Ledust-creat/mspm0-ball-balancing-car/chaiss/README.md

# MSPM0G3507 车载钢球平衡控制系统

完整项目介绍、功能、接线、构建步骤和已知问题见[仓库首页 README](../README.md)。

本目录为 MCU 固件工程；Keil 构建入口为 `keil/main.uvprojx`，芯片配置源文件为 `main.syscfg`。
