Ledust-creat/mspm0-ball-balancing-car/chaiss/app/app_chassis_control.h

#ifndef APP_CHASSIS_CONTROL_H_
#define APP_CHASSIS_CONTROL_H_

#include <stdbool.h>
#include <stdint.h>

#ifdef __cplusplus
extern "C" {
#endif

/*
*********************************************************************************************************
*   宏定义
*********************************************************************************************************
*/
#define APP_CHASSIS_CONTROL_MODE_LINE_FOLLOW    (0U)      /* 循迹外环 */
#define APP_CHASSIS_CONTROL_MODE_GYRO_YAW       (1U)      /* 陀螺仪yaw外环 */
#define APP_CHASSIS_CONTROL_MODE_SPEED_TEST     (2U)      /* 纯速度环测试 */

#ifndef APP_CHASSIS_CONTROL_MODE
#define APP_CHASSIS_CONTROL_MODE                APP_CHASSIS_CONTROL_MODE_LINE_FOLLOW
#endif

/*
*********************************************************************************************************
*   类型定义
*********************************************************************************************************
*/
typedef struct
{
    float base_speed_cm_s;                  /* 普通模式基础速度 */
    float target_base_speed_cm_s;           /* 移动控球斜坡目标速度 */
    float planned_base_speed_cm_s;          /* 斜坡规划后的基础速度 */
    float planned_accel_cm_s2;              /* 最近一次规划加速度 */
    float mobile_accel_step_cm_s;           /* 每20ms加速步长 */
    float mobile_decel_step_cm_s;           /* 每20ms减速步长 */
    float steering_correction_cm_s;         /* 当前转向修正速度 */
    uint8_t control_mode;                   /* 当前外环模式 */
    bool is_running;                        /* 底盘运行状态 */
    bool ball_priority_mode;                /* 移动控球速度规划使能 */
    bool soft_stopped;                      /* 斜坡停车完成标志 */
} APP_ChassisControlState_t;

/*
*********************************************************************************************************
*   函数声明
*********************************************************************************************************
*/
void APP_ChassisControl_Init(void);
void APP_ChassisControl_Task(void);
void APP_ChassisControl_Start(void);
void APP_ChassisControl_Stop(void);
void APP_ChassisControl_SetBaseSpeedCmps(float base_speed_cm_s);
void APP_ChassisControl_SetTargetBaseSpeed(float speed_cm_s);
void APP_ChassisControl_SetBallPriorityMode(bool enable);
void APP_ChassisControl_SetMobileRampStep(float accel_step_cm_s,
                                          float decel_step_cm_s);
void APP_ChassisControl_RequestSoftStop(void);
bool APP_ChassisControl_IsSoftStopped(void);
float APP_ChassisControl_GetPlannedAccelCmps2(void);
void APP_ChassisControl_GetState(APP_ChassisControlState_t *state);

#ifdef __cplusplus
}
#endif

#endif /* APP_CHASSIS_CONTROL_H_ */
