Ledust-creat/mspm0-ball-balancing-car/chaiss/ti_msp_dl_config.c

/*
 * Copyright (c) 2023, Texas Instruments Incorporated
 * All rights reserved.
 *
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
 * *  Redistributions of source code must retain the above copyright
 *    notice, this list of conditions and the following disclaimer.
 *
 * *  Redistributions in binary form must reproduce the above copyright
 *    notice, this list of conditions and the following disclaimer in the
 *    documentation and/or other materials provided with the distribution.
 *
 * *  Neither the name of Texas Instruments Incorporated nor the names of
 *    its contributors may be used to endorse or promote products derived
 *    from this software without specific prior written permission.
 *
 * THIS SOFTWARE IS PROVIDED BY THE COPYRIGHT HOLDERS AND CONTRIBUTORS "AS IS"
 * AND ANY EXPRESS OR IMPLIED WARRANTIES, INCLUDING, BUT NOT LIMITED TO,
 * THE IMPLIED WARRANTIES OF MERCHANTABILITY AND FITNESS FOR A PARTICULAR
 * PURPOSE ARE DISCLAIMED. IN NO EVENT SHALL THE COPYRIGHT OWNER OR
 * CONTRIBUTORS BE LIABLE FOR ANY DIRECT, INDIRECT, INCIDENTAL, SPECIAL,
 * EXEMPLARY, OR CONSEQUENTIAL DAMAGES (INCLUDING, BUT NOT LIMITED TO,
 * PROCUREMENT OF SUBSTITUTE GOODS OR SERVICES; LOSS OF USE, DATA, OR PROFITS;
 * OR BUSINESS INTERRUPTION) HOWEVER CAUSED AND ON ANY THEORY OF LIABILITY,
 * WHETHER IN CONTRACT, STRICT LIABILITY, OR TORT (INCLUDING NEGLIGENCE OR
 * OTHERWISE) ARISING IN ANY WAY OUT OF THE USE OF THIS SOFTWARE,
 * EVEN IF ADVISED OF THE POSSIBILITY OF SUCH DAMAGE.
 */

/*
 *  ============ ti_msp_dl_config.c =============
 *  Configured MSPM0 DriverLib module definitions
 *
 *  DO NOT EDIT - This file is generated for the MSPM0G350X
 *  by the SysConfig tool.
 */

#include "ti_msp_dl_config.h"

DL_TimerA_backupConfig gChassis_Motor_PWMBackup;
DL_SPI_backupConfig gSPI_ICM20602Backup;

/*
 *  ======== SYSCFG_DL_init ========
 *  Perform any initialization needed before using any board APIs
 */
SYSCONFIG_WEAK void SYSCFG_DL_init(void)
{
    SYSCFG_DL_initPower();
    SYSCFG_DL_GPIO_init();
    /* Module-Specific Initializations*/
    SYSCFG_DL_SYSCTL_init();
    SYSCFG_DL_Chassis_Motor_PWM_init();
    SYSCFG_DL_TIMER_Chassis_Motor_Encoder_Read_init();
    SYSCFG_DL_I2C_0_init();
    SYSCFG_DL_UART_BLUETOOTH_init();
    SYSCFG_DL_UART_HTS25L_init();
    SYSCFG_DL_SPI_ICM20602_init();
    /* Ensure backup structures have no valid state */
	gChassis_Motor_PWMBackup.backupRdy 	= false;


	gSPI_ICM20602Backup.backupRdy 	= false;

}
/*
 * User should take care to save and restore register configuration in application.
 * See Retention Configuration section for more details.
 */
SYSCONFIG_WEAK bool SYSCFG_DL_saveConfiguration(void)
{
    bool retStatus = true;

	retStatus &= DL_TimerA_saveConfiguration(Chassis_Motor_PWM_INST, &gChassis_Motor_PWMBackup);
	retStatus &= DL_SPI_saveConfiguration(SPI_ICM20602_INST, &gSPI_ICM20602Backup);

    return retStatus;
}


SYSCONFIG_WEAK bool SYSCFG_DL_restoreConfiguration(void)
{
    bool retStatus = true;

	retStatus &= DL_TimerA_restoreConfiguration(Chassis_Motor_PWM_INST, &gChassis_Motor_PWMBackup, false);
	retStatus &= DL_SPI_restoreConfiguration(SPI_ICM20602_INST, &gSPI_ICM20602Backup);

    return retStatus;
}

SYSCONFIG_WEAK void SYSCFG_DL_initPower(void)
{
    DL_GPIO_reset(GPIOA);
    DL_GPIO_reset(GPIOB);
    DL_TimerA_reset(Chassis_Motor_PWM_INST);
    DL_TimerG_reset(TIMER_Chassis_Motor_Encoder_Read_INST);
    DL_I2C_reset(I2C_0_INST);
    DL_UART_Main_reset(UART_BLUETOOTH_INST);
    DL_UART_Main_reset(UART_HTS25L_INST);
    DL_SPI_reset(SPI_ICM20602_INST);

    DL_GPIO_enablePower(GPIOA);
    DL_GPIO_enablePower(GPIOB);
    DL_TimerA_enablePower(Chassis_Motor_PWM_INST);
    DL_TimerG_enablePower(TIMER_Chassis_Motor_Encoder_Read_INST);
    DL_I2C_enablePower(I2C_0_INST);
    DL_UART_Main_enablePower(UART_BLUETOOTH_INST);
    DL_UART_Main_enablePower(UART_HTS25L_INST);
    DL_SPI_enablePower(SPI_ICM20602_INST);
    delay_cycles(POWER_STARTUP_DELAY);
}

SYSCONFIG_WEAK void SYSCFG_DL_GPIO_init(void)
{

    DL_GPIO_initPeripheralAnalogFunction(GPIO_HFXIN_IOMUX);
    DL_GPIO_initPeripheralAnalogFunction(GPIO_HFXOUT_IOMUX);

    DL_GPIO_initPeripheralOutputFunction(GPIO_Chassis_Motor_PWM_C0_IOMUX,GPIO_Chassis_Motor_PWM_C0_IOMUX_FUNC);
    DL_GPIO_enableOutput(GPIO_Chassis_Motor_PWM_C0_PORT, GPIO_Chassis_Motor_PWM_C0_PIN);
    DL_GPIO_initPeripheralOutputFunction(GPIO_Chassis_Motor_PWM_C1_IOMUX,GPIO_Chassis_Motor_PWM_C1_IOMUX_FUNC);
    DL_GPIO_enableOutput(GPIO_Chassis_Motor_PWM_C1_PORT, GPIO_Chassis_Motor_PWM_C1_PIN);

    DL_GPIO_initPeripheralInputFunctionFeatures(GPIO_I2C_0_IOMUX_SDA,
        GPIO_I2C_0_IOMUX_SDA_FUNC, DL_GPIO_INVERSION_DISABLE,
        DL_GPIO_RESISTOR_NONE, DL_GPIO_HYSTERESIS_DISABLE,
        DL_GPIO_WAKEUP_DISABLE);
    DL_GPIO_initPeripheralInputFunctionFeatures(GPIO_I2C_0_IOMUX_SCL,
        GPIO_I2C_0_IOMUX_SCL_FUNC, DL_GPIO_INVERSION_DISABLE,
        DL_GPIO_RESISTOR_NONE, DL_GPIO_HYSTERESIS_DISABLE,
        DL_GPIO_WAKEUP_DISABLE);
    DL_GPIO_enableHiZ(GPIO_I2C_0_IOMUX_SDA);
    DL_GPIO_enableHiZ(GPIO_I2C_0_IOMUX_SCL);

    DL_GPIO_initPeripheralOutputFunction(
        GPIO_UART_BLUETOOTH_IOMUX_TX, GPIO_UART_BLUETOOTH_IOMUX_TX_FUNC);
    DL_GPIO_initPeripheralInputFunction(
        GPIO_UART_BLUETOOTH_IOMUX_RX, GPIO_UART_BLUETOOTH_IOMUX_RX_FUNC);
    DL_GPIO_initPeripheralOutputFunction(
        GPIO_UART_HTS25L_IOMUX_TX, GPIO_UART_HTS25L_IOMUX_TX_FUNC);
    DL_GPIO_initPeripheralInputFunction(
        GPIO_UART_HTS25L_IOMUX_RX, GPIO_UART_HTS25L_IOMUX_RX_FUNC);

    DL_GPIO_initPeripheralOutputFunction(
        GPIO_SPI_ICM20602_IOMUX_SCLK, GPIO_SPI_ICM20602_IOMUX_SCLK_FUNC);
    DL_GPIO_initPeripheralOutputFunction(
        GPIO_SPI_ICM20602_IOMUX_PICO, GPIO_SPI_ICM20602_IOMUX_PICO_FUNC);
    DL_GPIO_initPeripheralInputFunction(
        GPIO_SPI_ICM20602_IOMUX_POCI, GPIO_SPI_ICM20602_IOMUX_POCI_FUNC);

    DL_GPIO_initDigitalOutput(led_PIN_0_IOMUX);

    DL_GPIO_initDigitalOutputFeatures(ICM20602_PIN_1_IOMUX,
		 DL_GPIO_INVERSION_DISABLE, DL_GPIO_RESISTOR_PULL_UP,
		 DL_GPIO_DRIVE_STRENGTH_LOW, DL_GPIO_HIZ_DISABLE);

    DL_GPIO_initDigitalOutput(Chassis_MotorA_AIN1_IOMUX);

    DL_GPIO_initDigitalOutput(Chassis_MotorA_AIN2_IOMUX);

    DL_GPIO_initDigitalOutput(Chassis_MotorB_BIN1_IOMUX);

    DL_GPIO_initDigitalOutput(Chassis_MotorB_BIN2_IOMUX);

    DL_GPIO_initDigitalInputFeatures(Digital_D1_IOMUX,
		 DL_GPIO_INVERSION_DISABLE, DL_GPIO_RESISTOR_PULL_UP,
		 DL_GPIO_HYSTERESIS_DISABLE, DL_GPIO_WAKEUP_DISABLE);

    DL_GPIO_initDigitalInputFeatures(Digital_D2_IOMUX,
		 DL_GPIO_INVERSION_DISABLE, DL_GPIO_RESISTOR_PULL_UP,
		 DL_GPIO_HYSTERESIS_DISABLE, DL_GPIO_WAKEUP_DISABLE);

    DL_GPIO_initDigitalInputFeatures(Digital_D3_IOMUX,
		 DL_GPIO_INVERSION_DISABLE, DL_GPIO_RESISTOR_PULL_UP,
		 DL_GPIO_HYSTERESIS_DISABLE, DL_GPIO_WAKEUP_DISABLE);

    DL_GPIO_initDigitalInputFeatures(Digital_D4_IOMUX,
		 DL_GPIO_INVERSION_DISABLE, DL_GPIO_RESISTOR_PULL_UP,
		 DL_GPIO_HYSTERESIS_DISABLE, DL_GPIO_WAKEUP_DISABLE);

    DL_GPIO_initDigitalInputFeatures(Digital_D5_IOMUX,
		 DL_GPIO_INVERSION_DISABLE, DL_GPIO_RESISTOR_PULL_UP,
		 DL_GPIO_HYSTERESIS_DISABLE, DL_GPIO_WAKEUP_DISABLE);

    DL_GPIO_initDigitalInputFeatures(Digital_D6_IOMUX,
		 DL_GPIO_INVERSION_DISABLE, DL_GPIO_RESISTOR_PULL_UP,
		 DL_GPIO_HYSTERESIS_DISABLE, DL_GPIO_WAKEUP_DISABLE);

    DL_GPIO_initDigitalInputFeatures(Digital_D7_IOMUX,
		 DL_GPIO_INVERSION_DISABLE, DL_GPIO_RESISTOR_PULL_UP,
		 DL_GPIO_HYSTERESIS_DISABLE, DL_GPIO_WAKEUP_DISABLE);

    DL_GPIO_initDigitalInputFeatures(Digital_D8_IOMUX,
		 DL_GPIO_INVERSION_DISABLE, DL_GPIO_RESISTOR_PULL_UP,
		 DL_GPIO_HYSTERESIS_DISABLE, DL_GPIO_WAKEUP_DISABLE);

    DL_GPIO_initDigitalInputFeatures(EncoderA_E1A_IOMUX,
		 DL_GPIO_INVERSION_DISABLE, DL_GPIO_RESISTOR_PULL_UP,
		 DL_GPIO_HYSTERESIS_DISABLE, DL_GPIO_WAKEUP_DISABLE);

    DL_GPIO_initDigitalInputFeatures(EncoderA_E1B_IOMUX,
		 DL_GPIO_INVERSION_DISABLE, DL_GPIO_RESISTOR_PULL_UP,
		 DL_GPIO_HYSTERESIS_DISABLE, DL_GPIO_WAKEUP_DISABLE);

    DL_GPIO_initDigitalInputFeatures(EncoderB_E2A_IOMUX,
		 DL_GPIO_INVERSION_DISABLE, DL_GPIO_RESISTOR_PULL_UP,
		 DL_GPIO_HYSTERESIS_DISABLE, DL_GPIO_WAKEUP_DISABLE);

    DL_GPIO_initDigitalInputFeatures(EncoderB_E2B_IOMUX,
		 DL_GPIO_INVERSION_DISABLE, DL_GPIO_RESISTOR_PULL_UP,
		 DL_GPIO_HYSTERESIS_DISABLE, DL_GPIO_WAKEUP_DISABLE);

    DL_GPIO_initDigitalInputFeatures(KEY_SELECT_IOMUX,
		 DL_GPIO_INVERSION_DISABLE, DL_GPIO_RESISTOR_PULL_UP,
		 DL_GPIO_HYSTERESIS_DISABLE, DL_GPIO_WAKEUP_DISABLE);

    DL_GPIO_initDigitalInputFeatures(KEY_CONFIRM_IOMUX,
		 DL_GPIO_INVERSION_DISABLE, DL_GPIO_RESISTOR_PULL_UP,
		 DL_GPIO_HYSTERESIS_DISABLE, DL_GPIO_WAKEUP_DISABLE);

    DL_GPIO_initDigitalInputFeatures(KEY_ADD_IOMUX,
		 DL_GPIO_INVERSION_DISABLE, DL_GPIO_RESISTOR_PULL_UP,
		 DL_GPIO_HYSTERESIS_DISABLE, DL_GPIO_WAKEUP_DISABLE);

    DL_GPIO_initDigitalInputFeatures(KEY_SUB_IOMUX,
		 DL_GPIO_INVERSION_DISABLE, DL_GPIO_RESISTOR_PULL_UP,
		 DL_GPIO_HYSTERESIS_DISABLE, DL_GPIO_WAKEUP_DISABLE);

    DL_GPIO_clearPins(GPIOA, Chassis_MotorB_BIN1_PIN);
    DL_GPIO_enableOutput(GPIOA, Chassis_MotorB_BIN1_PIN);
    DL_GPIO_setLowerPinsPolarity(GPIOA, DL_GPIO_PIN_13_EDGE_RISE_FALL);
    DL_GPIO_clearInterruptStatus(GPIOA, EncoderB_E2A_PIN);
    DL_GPIO_enableInterrupt(GPIOA, EncoderB_E2A_PIN);
    DL_GPIO_clearPins(GPIOB, led_PIN_0_PIN |
		Chassis_MotorA_AIN1_PIN |
		Chassis_MotorA_AIN2_PIN |
		Chassis_MotorB_BIN2_PIN);
    DL_GPIO_setPins(GPIOB, ICM20602_PIN_1_PIN);
    DL_GPIO_enableOutput(GPIOB, led_PIN_0_PIN |
		ICM20602_PIN_1_PIN |
		Chassis_MotorA_AIN1_PIN |
		Chassis_MotorA_AIN2_PIN |
		Chassis_MotorB_BIN2_PIN);
    DL_GPIO_setUpperPinsPolarity(GPIOB, DL_GPIO_PIN_26_EDGE_RISE_FALL);
    DL_GPIO_clearInterruptStatus(GPIOB, EncoderA_E1A_PIN);
    DL_GPIO_enableInterrupt(GPIOB, EncoderA_E1A_PIN);

}


static const DL_SYSCTL_SYSPLLConfig gSYSPLLConfig = {
    .inputFreq              = DL_SYSCTL_SYSPLL_INPUT_FREQ_32_48_MHZ,
	.rDivClk2x              = 1,
	.rDivClk1               = 0,
	.rDivClk0               = 0,
	.enableCLK2x            = DL_SYSCTL_SYSPLL_CLK2X_DISABLE,
	.enableCLK1             = DL_SYSCTL_SYSPLL_CLK1_DISABLE,
	.enableCLK0             = DL_SYSCTL_SYSPLL_CLK0_ENABLE,
	.sysPLLMCLK             = DL_SYSCTL_SYSPLL_MCLK_CLK0,
	.sysPLLRef              = DL_SYSCTL_SYSPLL_REF_HFCLK,
	.qDiv                   = 3,
	.pDiv                   = DL_SYSCTL_SYSPLL_PDIV_1
};

SYSCONFIG_WEAK bool SYSCFG_DL_SYSCTL_SYSPLL_init(void)
{
    bool fFCCRatioStatus = false;
    uint32_t fFCCSysoscCount;
    uint32_t fFCCPllCount;
    uint32_t fFCCRatio;
    uint32_t fccTimeOutCounter;

    DL_SYSCTL_setFCCPeriods( DL_SYSCTL_FCC_TRIG_CNT_01 );

    /* Measuring PLL. */
    DL_SYSCTL_configFCC(DL_SYSCTL_FCC_TRIG_TYPE_RISE_RISE,
                        DL_SYSCTL_FCC_TRIG_SOURCE_LFCLK,
                        DL_SYSCTL_FCC_CLOCK_SOURCE_SYSPLLCLK0);
    /* Get SYSPLL frequency using FCC */
    fccTimeOutCounter = 0;
    DL_SYSCTL_startFCC();
    while (DL_SYSCTL_isFCCDone() == 0) {
        delay_cycles(977);  /* 1x LFCLK cycle = 32MHz/32.768kHz = 977, 30.5us */
        fccTimeOutCounter++;
        if(fccTimeOutCounter > 65){
            /* Timeout set to approximately 2ms (user-customizable) */
            break;
        }
    }

    /* get measA= SYSPLLCLK0 freq wrt LFOSC*/
    fFCCPllCount = DL_SYSCTL_readFCC();

    /* Measuring SYSPLL Source */
    DL_SYSCTL_configFCC(DL_SYSCTL_FCC_TRIG_TYPE_RISE_RISE,
                        DL_SYSCTL_FCC_TRIG_SOURCE_LFCLK,
                        DL_SYSCTL_FCC_CLOCK_SOURCE_HFCLK);
    /* Get SYSPLL frequency using FCC */
    fccTimeOutCounter = 0;
    DL_SYSCTL_startFCC();
    while (DL_SYSCTL_isFCCDone() == 0) {
        delay_cycles(977);  /* 1x LFCLK cycle = 32MHz/32.768kHz = 977, 30.5us */
        fccTimeOutCounter++;
        if(fccTimeOutCounter > 65){
            /* Timeout set to approximately 2ms (user-customizable) */
            break;
        }
    }

    /* get measB= SYSOSC freq wrt LFOSC*/
    fFCCSysoscCount = DL_SYSCTL_readFCC();

    /* Get ratio of both measurements*/
    fFCCRatio = (fFCCPllCount * FLOAT_TO_INT_SCALE) / fFCCSysoscCount;
    /* Check ratio is within bounds*/
    if ((FCC_LOWER_BOUND <  fFCCRatio) && (fFCCRatio < FCC_UPPER_BOUND))
    {
        /* ratio is good for proceeding into application code. */
        fFCCRatioStatus = true;
    }

    return fFCCRatioStatus;
}
SYSCONFIG_WEAK void SYSCFG_DL_SYSCTL_init(void)
{

	//Low Power Mode is configured to be SLEEP0
    DL_SYSCTL_setBORThreshold(DL_SYSCTL_BOR_THRESHOLD_LEVEL_0);
    DL_SYSCTL_setFlashWaitState(DL_SYSCTL_FLASH_WAIT_STATE_2);

    
	DL_SYSCTL_setSYSOSCFreq(DL_SYSCTL_SYSOSC_FREQ_BASE);
	/* Set default configuration */
	DL_SYSCTL_disableHFXT();
	DL_SYSCTL_disableSYSPLL();
    DL_SYSCTL_setHFCLKSourceHFXTParams(DL_SYSCTL_HFXT_RANGE_32_48_MHZ,100, false);
    DL_SYSCTL_configSYSPLL((DL_SYSCTL_SYSPLLConfig *) &gSYSPLLConfig);

    /*
     * [SYSPLL_ERR_01]
     * PLL Incorrect locking WA start.
     * Insert after every PLL enable.
     * This can lead an infinite loop if the condition persists
     * and can block entry to the application code.
     */

    while (SYSCFG_DL_SYSCTL_SYSPLL_init() == false)
    {
        /* Toggle SYSPLL enable to re-enable SYSPLL and re-check incorrect locking */
        DL_SYSCTL_disableSYSPLL();
        DL_SYSCTL_enableSYSPLL();

        /* Wait until SYSPLL startup is stabilized*/
        while ((DL_SYSCTL_getClockStatus() & SYSCTL_CLKSTATUS_SYSPLLGOOD_MASK) != DL_SYSCTL_CLK_STATUS_SYSPLL_GOOD){}
    }
    DL_SYSCTL_setULPCLKDivider(DL_SYSCTL_ULPCLK_DIV_2);
    DL_SYSCTL_setMCLKSource(SYSOSC, HSCLK, DL_SYSCTL_HSCLK_SOURCE_SYSPLL);

}


/*
 * Timer clock configuration to be sourced by  / 1 (80000000 Hz)
 * timerClkFreq = (timerClkSrc / (timerClkDivRatio * (timerClkPrescale + 1)))
 *   80000000 Hz = 80000000 Hz / (1 * (0 + 1))
 */
static const DL_TimerA_ClockConfig gChassis_Motor_PWMClockConfig = {
    .clockSel = DL_TIMER_CLOCK_BUSCLK,
    .divideRatio = DL_TIMER_CLOCK_DIVIDE_1,
    .prescale = 0U
};

static const DL_TimerA_PWMConfig gChassis_Motor_PWMConfig = {
    .pwmMode = DL_TIMER_PWM_MODE_EDGE_ALIGN_UP,
    .period = 2500,
    .isTimerWithFourCC = true,
    .startTimer = DL_TIMER_START,
};

SYSCONFIG_WEAK void SYSCFG_DL_Chassis_Motor_PWM_init(void) {

    DL_TimerA_setClockConfig(
        Chassis_Motor_PWM_INST, (DL_TimerA_ClockConfig *) &gChassis_Motor_PWMClockConfig);

    DL_TimerA_initPWMMode(
        Chassis_Motor_PWM_INST, (DL_TimerA_PWMConfig *) &gChassis_Motor_PWMConfig);

    // Set Counter control to the smallest CC index being used
    DL_TimerA_setCounterControl(Chassis_Motor_PWM_INST,DL_TIMER_CZC_CCCTL0_ZCOND,DL_TIMER_CAC_CCCTL0_ACOND,DL_TIMER_CLC_CCCTL0_LCOND);

    DL_TimerA_setCaptureCompareOutCtl(Chassis_Motor_PWM_INST, DL_TIMER_CC_OCTL_INIT_VAL_LOW,
		DL_TIMER_CC_OCTL_INV_OUT_DISABLED, DL_TIMER_CC_OCTL_SRC_FUNCVAL,
		DL_TIMERA_CAPTURE_COMPARE_0_INDEX);

    DL_TimerA_setCaptCompUpdateMethod(Chassis_Motor_PWM_INST, DL_TIMER_CC_UPDATE_METHOD_IMMEDIATE, DL_TIMERA_CAPTURE_COMPARE_0_INDEX);
    DL_TimerA_setCaptureCompareValue(Chassis_Motor_PWM_INST, 0, DL_TIMER_CC_0_INDEX);

    DL_TimerA_setCaptureCompareOutCtl(Chassis_Motor_PWM_INST, DL_TIMER_CC_OCTL_INIT_VAL_LOW,
		DL_TIMER_CC_OCTL_INV_OUT_DISABLED, DL_TIMER_CC_OCTL_SRC_FUNCVAL,
		DL_TIMERA_CAPTURE_COMPARE_1_INDEX);

    DL_TimerA_setCaptCompUpdateMethod(Chassis_Motor_PWM_INST, DL_TIMER_CC_UPDATE_METHOD_IMMEDIATE, DL_TIMERA_CAPTURE_COMPARE_1_INDEX);
    DL_TimerA_setCaptureCompareValue(Chassis_Motor_PWM_INST, 0, DL_TIMER_CC_1_INDEX);

    DL_TimerA_enableClock(Chassis_Motor_PWM_INST);


    
    DL_TimerA_setCCPDirection(Chassis_Motor_PWM_INST , DL_TIMER_CC0_OUTPUT | DL_TIMER_CC1_OUTPUT );


}



/*
 * Timer clock configuration to be sourced by BUSCLK /  (40000000 Hz)
 * timerClkFreq = (timerClkSrc / (timerClkDivRatio * (timerClkPrescale + 1)))
 *   156250 Hz = 40000000 Hz / (1 * (255 + 1))
 */
static const DL_TimerG_ClockConfig gTIMER_Chassis_Motor_Encoder_ReadClockConfig = {
    .clockSel    = DL_TIMER_CLOCK_BUSCLK,
    .divideRatio = DL_TIMER_CLOCK_DIVIDE_1,
    .prescale    = 255U,
};

/*
 * Timer load value (where the counter starts from) is calculated as (timerPeriod * timerClockFreq) - 1
 * TIMER_Chassis_Motor_Encoder_Read_INST_LOAD_VALUE = (20 ms * 156250 Hz) - 1
 */
static const DL_TimerG_TimerConfig gTIMER_Chassis_Motor_Encoder_ReadTimerConfig = {
    .period     = TIMER_Chassis_Motor_Encoder_Read_INST_LOAD_VALUE,
    .timerMode  = DL_TIMER_TIMER_MODE_PERIODIC,
    .startTimer = DL_TIMER_START,
};

SYSCONFIG_WEAK void SYSCFG_DL_TIMER_Chassis_Motor_Encoder_Read_init(void) {

    DL_TimerG_setClockConfig(TIMER_Chassis_Motor_Encoder_Read_INST,
        (DL_TimerG_ClockConfig *) &gTIMER_Chassis_Motor_Encoder_ReadClockConfig);

    DL_TimerG_initTimerMode(TIMER_Chassis_Motor_Encoder_Read_INST,
        (DL_TimerG_TimerConfig *) &gTIMER_Chassis_Motor_Encoder_ReadTimerConfig);
    DL_TimerG_enableInterrupt(TIMER_Chassis_Motor_Encoder_Read_INST , DL_TIMERG_INTERRUPT_ZERO_EVENT);
    DL_TimerG_enableClock(TIMER_Chassis_Motor_Encoder_Read_INST);





}


static const DL_I2C_ClockConfig gI2C_0ClockConfig = {
    .clockSel = DL_I2C_CLOCK_BUSCLK,
    .divideRatio = DL_I2C_CLOCK_DIVIDE_1,
};

SYSCONFIG_WEAK void SYSCFG_DL_I2C_0_init(void) {

    DL_I2C_setClockConfig(I2C_0_INST,
        (DL_I2C_ClockConfig *) &gI2C_0ClockConfig);
    DL_I2C_setAnalogGlitchFilterPulseWidth(I2C_0_INST,
        DL_I2C_ANALOG_GLITCH_FILTER_WIDTH_50NS);
    DL_I2C_enableAnalogGlitchFilter(I2C_0_INST);

    /* Configure Controller Mode */
    DL_I2C_resetControllerTransfer(I2C_0_INST);
    /* Set frequency to 400000 Hz*/
    DL_I2C_setTimerPeriod(I2C_0_INST, 9);
    DL_I2C_setControllerTXFIFOThreshold(I2C_0_INST, DL_I2C_TX_FIFO_LEVEL_EMPTY);
    DL_I2C_setControllerRXFIFOThreshold(I2C_0_INST, DL_I2C_RX_FIFO_LEVEL_BYTES_1);
    DL_I2C_enableControllerClockStretching(I2C_0_INST);


    /* Enable module */
    DL_I2C_enableController(I2C_0_INST);


}

static const DL_UART_Main_ClockConfig gUART_BLUETOOTHClockConfig = {
    .clockSel    = DL_UART_MAIN_CLOCK_BUSCLK,
    .divideRatio = DL_UART_MAIN_CLOCK_DIVIDE_RATIO_1
};

static const DL_UART_Main_Config gUART_BLUETOOTHConfig = {
    .mode        = DL_UART_MAIN_MODE_NORMAL,
    .direction   = DL_UART_MAIN_DIRECTION_TX_RX,
    .flowControl = DL_UART_MAIN_FLOW_CONTROL_NONE,
    .parity      = DL_UART_MAIN_PARITY_NONE,
    .wordLength  = DL_UART_MAIN_WORD_LENGTH_8_BITS,
    .stopBits    = DL_UART_MAIN_STOP_BITS_ONE
};

SYSCONFIG_WEAK void SYSCFG_DL_UART_BLUETOOTH_init(void)
{
    DL_UART_Main_setClockConfig(UART_BLUETOOTH_INST, (DL_UART_Main_ClockConfig *) &gUART_BLUETOOTHClockConfig);

    DL_UART_Main_init(UART_BLUETOOTH_INST, (DL_UART_Main_Config *) &gUART_BLUETOOTHConfig);
    /*
     * Configure baud rate by setting oversampling and baud rate divisors.
     *  Target baud rate: 115200
     *  Actual baud rate: 115190.78
     */
    DL_UART_Main_setOversampling(UART_BLUETOOTH_INST, DL_UART_OVERSAMPLING_RATE_16X);
    DL_UART_Main_setBaudRateDivisor(UART_BLUETOOTH_INST, UART_BLUETOOTH_IBRD_40_MHZ_115200_BAUD, UART_BLUETOOTH_FBRD_40_MHZ_115200_BAUD);


    /* Configure Interrupts */
    DL_UART_Main_enableInterrupt(UART_BLUETOOTH_INST,
                                 DL_UART_MAIN_INTERRUPT_RX);


    DL_UART_Main_enable(UART_BLUETOOTH_INST);
}
static const DL_UART_Main_ClockConfig gUART_HTS25LClockConfig = {
    .clockSel    = DL_UART_MAIN_CLOCK_BUSCLK,
    .divideRatio = DL_UART_MAIN_CLOCK_DIVIDE_RATIO_1
};

static const DL_UART_Main_Config gUART_HTS25LConfig = {
    .mode        = DL_UART_MAIN_MODE_NORMAL,
    .direction   = DL_UART_MAIN_DIRECTION_TX_RX,
    .flowControl = DL_UART_MAIN_FLOW_CONTROL_NONE,
    .parity      = DL_UART_MAIN_PARITY_NONE,
    .wordLength  = DL_UART_MAIN_WORD_LENGTH_8_BITS,
    .stopBits    = DL_UART_MAIN_STOP_BITS_ONE
};

SYSCONFIG_WEAK void SYSCFG_DL_UART_HTS25L_init(void)
{
    DL_UART_Main_setClockConfig(UART_HTS25L_INST, (DL_UART_Main_ClockConfig *) &gUART_HTS25LClockConfig);

    DL_UART_Main_init(UART_HTS25L_INST, (DL_UART_Main_Config *) &gUART_HTS25LConfig);
    /*
     * Configure baud rate by setting oversampling and baud rate divisors.
     *  Target baud rate: 115200
     *  Actual baud rate: 115190.78
     */
    DL_UART_Main_setOversampling(UART_HTS25L_INST, DL_UART_OVERSAMPLING_RATE_16X);
    DL_UART_Main_setBaudRateDivisor(UART_HTS25L_INST, UART_HTS25L_IBRD_40_MHZ_115200_BAUD, UART_HTS25L_FBRD_40_MHZ_115200_BAUD);


    /* Configure Interrupts */
    DL_UART_Main_enableInterrupt(UART_HTS25L_INST,
                                 DL_UART_MAIN_INTERRUPT_RX);


    DL_UART_Main_enable(UART_HTS25L_INST);
}

static const DL_SPI_Config gSPI_ICM20602_config = {
    .mode        = DL_SPI_MODE_CONTROLLER,
    .frameFormat = DL_SPI_FRAME_FORMAT_MOTO3_POL1_PHA1,
    .parity      = DL_SPI_PARITY_NONE,
    .dataSize    = DL_SPI_DATA_SIZE_8,
    .bitOrder    = DL_SPI_BIT_ORDER_MSB_FIRST,
};

static const DL_SPI_ClockConfig gSPI_ICM20602_clockConfig = {
    .clockSel    = DL_SPI_CLOCK_BUSCLK,
    .divideRatio = DL_SPI_CLOCK_DIVIDE_RATIO_1
};

SYSCONFIG_WEAK void SYSCFG_DL_SPI_ICM20602_init(void) {
    DL_SPI_setClockConfig(SPI_ICM20602_INST, (DL_SPI_ClockConfig *) &gSPI_ICM20602_clockConfig);

    DL_SPI_init(SPI_ICM20602_INST, (DL_SPI_Config *) &gSPI_ICM20602_config);

    /* Configure Controller mode */
    /*
     * Set the bit rate clock divider to generate the serial output clock
     *     outputBitRate = (spiInputClock) / ((1 + SCR) * 2)
     *     1000000 = (80000000)/((1 + 39) * 2)
     */
    DL_SPI_setBitRateSerialClockDivider(SPI_ICM20602_INST, 39);
    /* Set RX and TX FIFO threshold levels */
    DL_SPI_setFIFOThreshold(SPI_ICM20602_INST, DL_SPI_RX_FIFO_LEVEL_1_2_FULL, DL_SPI_TX_FIFO_LEVEL_1_2_EMPTY);

    /* Enable module */
    DL_SPI_enable(SPI_ICM20602_INST);
}
