Ledust-creat/mspm0-ball-balancing-car/chaiss/BSP/bsp_key.c

#include "bsp_key.h"
#include "ti_msp_dl_config.h"

/*
*********************************************************************************************************
*   函 数 名: BSP_Key_Init
*   功能说明: 初始化按键BSP层
*   形    参: 无
*   返 回 值: 无
*********************************************************************************************************
*/
void BSP_Key_Init(void)
{
    /*
     * GPIO输入和上拉由SysConfig完成。
     */
}

/*
*********************************************************************************************************
*   函 数 名: BSP_Key_IsSelectPressed
*   功能说明: 读取SELECT按键原始按下状态
*   形    参: 无
*   返 回 值: true按下，false松开
*********************************************************************************************************
*/
bool BSP_Key_IsSelectPressed(void)
{
    return (DL_GPIO_readPins(KEY_SELECT_PORT, KEY_SELECT_PIN) == 0U);
}

/*
*********************************************************************************************************
*   函 数 名: BSP_Key_IsConfirmPressed
*   功能说明: 读取CONFIRM按键原始按下状态
*   形    参: 无
*   返 回 值: true按下，false松开
*********************************************************************************************************
*/
bool BSP_Key_IsConfirmPressed(void)
{
    return (DL_GPIO_readPins(KEY_CONFIRM_PORT, KEY_CONFIRM_PIN) == 0U);
}

/*
*********************************************************************************************************
*   函 数 名: BSP_Key_IsZeroDecPressed
*   功能说明: 读取舵机零点减小按键状态
*   形    参: 无
*   返 回 值: true按下，false松开
*********************************************************************************************************
*/
bool BSP_Key_IsZeroDecPressed(void)
{
    return (DL_GPIO_readPins(KEY_SUB_PORT, KEY_SUB_PIN) == 0U);
}

/*
*********************************************************************************************************
*   函 数 名: BSP_Key_IsZeroIncPressed
*   功能说明: 读取舵机零点增加按键状态
*   形    参: 无
*   返 回 值: true按下，false松开
*********************************************************************************************************
*/
bool BSP_Key_IsZeroIncPressed(void)
{
    return (DL_GPIO_readPins(KEY_ADD_PORT, KEY_ADD_PIN) == 0U);
}
