Ledust-creat/mspm0-ball-balancing-car/chaiss/BSP/bsp_key.h

#ifndef BSP_KEY_H_
#define BSP_KEY_H_

#include <stdbool.h>

#ifdef __cplusplus
extern "C" {
#endif

/*
*********************************************************************************************************
*   函数声明
*********************************************************************************************************
*/
void BSP_Key_Init(void);
bool BSP_Key_IsSelectPressed(void);
bool BSP_Key_IsConfirmPressed(void);
bool BSP_Key_IsZeroDecPressed(void);
bool BSP_Key_IsZeroIncPressed(void);

#ifdef __cplusplus
}
#endif

#endif /* BSP_KEY_H_ */
