Ledust-creat/mspm0-ball-balancing-car/chaiss/total.h

#ifndef TOTAL_H_
#define TOTAL_H_

#include "ti_msp_dl_config.h"
#include "interrupt.h"
#include "PID.h"
#include "bsp_chassis_motor.h"
#include "bsp_encoder.h"
#include "bsp_bluetooth.h"
#include "bsp_k230_uart.h"
#include "bsp_key.h"
#include "dve_chassis.h"
#include "dve_ir_sensor.h"
#include "app_line_follow.h"
#include "app_chassis_control.h"
#include "app_gyro_control.h"
#include "app_k230_input.h"
#include "app_competition_menu.h"
#include "app_competition_control.h"
#include "app_task_track_lap.h"
#include "app_task_static_ball.h"
#include "app_task_mobile_ball.h"
#include "app_scheduler.h"
#include "dve_icm20602.h"
#include "bsp_gyro_spi.h"
#include "app_command.h"

#endif /* TOTAL_H_ */
