Ledust-creat/mspm0-ball-balancing-car/(commit log)

2026-07-21 2026-07-21 chassis encoder speed-loop bluetooth-tuning runnable
2026-07-22 2026-07-22 chassis encoder speed-loop line-follow runnable
2026-07-24 2026-07-21 chassis imu runnable
2026-07-26 2026-07-26 chassis优化编码器和灰度传感器
2026-07-30 简单菜单
2026-07-30 优化菜单
2026-07-30 ## OLED运行时间、K230真实收帧时间、BallControl结构简化、注释补全与IMU周期采样
2026-07-30 龙门架pid
2026-07-31 第三问&&循迹优化
2026-07-31 舵机反向
2026-07-31 第三问+-5cm
2026-07-31 第四问起
2026-10-11 fix: 停车线识别不再依赖弯道计数
2026-10-11 docs: 补充项目功能、接线与构建说明
2026-10-11 fix: 保留任务切换时的Kv和Ka调参值
2026-10-12 docs: 补充整车照片与扩展板原理图
2026-10-12 docs: 添加 MIT 开源许可证
